mdion1/LightsAndSoundProj/Datasheets/MO063602-1 dimension capture.png

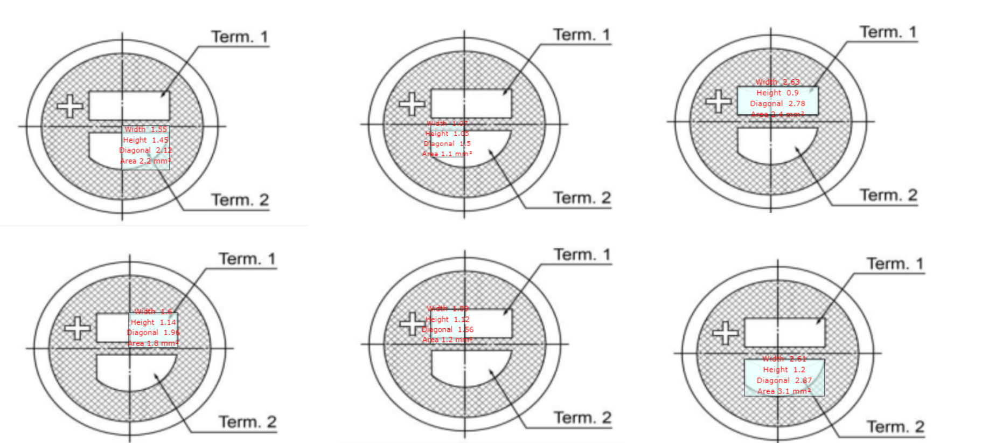
Datasheets/MO063602-1 dimension capture.png
