mdion1/LightsAndSoundProj/UsefulScripts/DFTFilterDesign/SampleScriptOutput.png

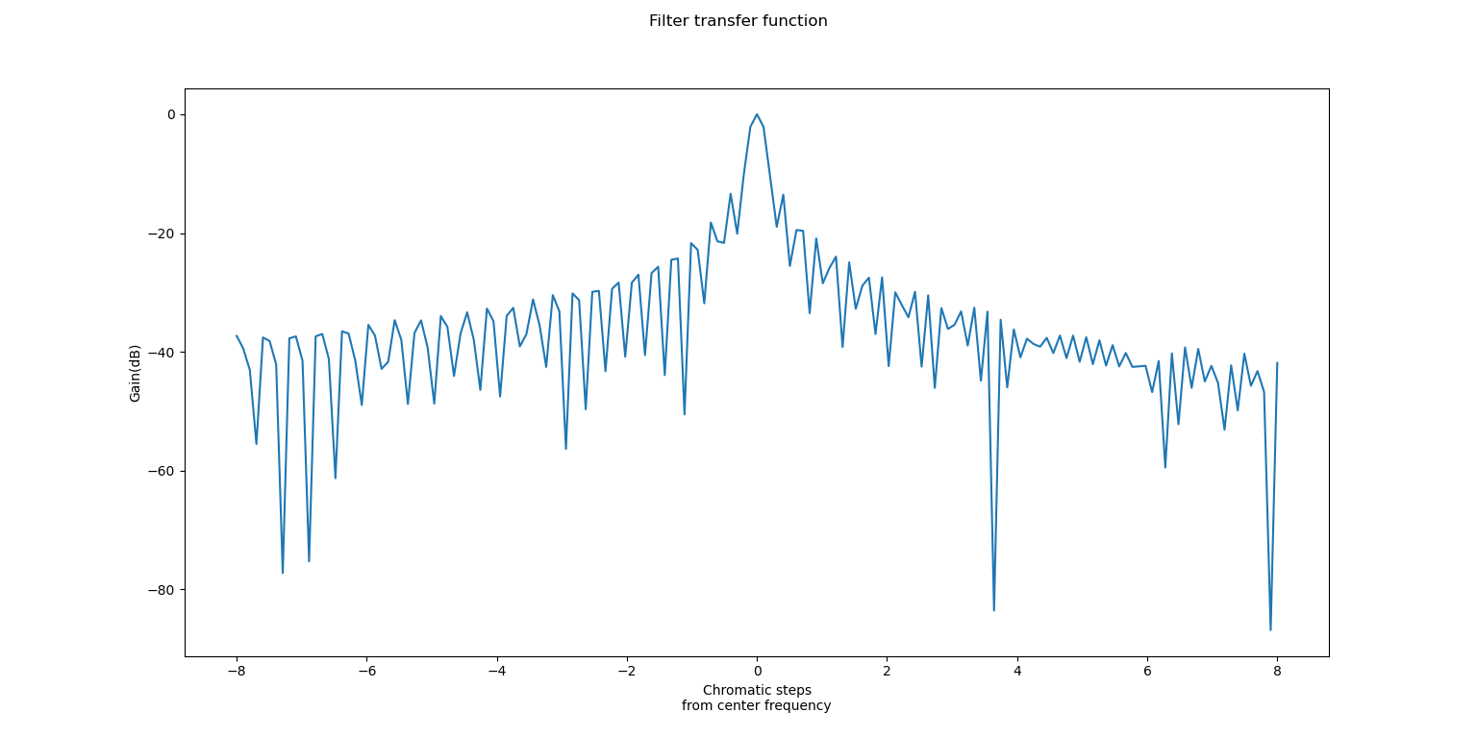
UsefulScripts/DFTFilterDesign/SampleScriptOutput.png
