mdion1/LightsAndSoundProj/Simulations/GainStage_DCanalysis.asc

C6: cap; 5p
C10: cap; 5p
C_pin: cap; 50p
R1: res; 10k
R9: res; 10k
R13: res; {R_fbTop}
R14: res; {R_fbTop}
R15: res; {R_fbBot}
R16: res; 1k
U1: UniversalOpAmp; Avol=0.5Meg GBW=0.73Meg Vos={V_inputOffset}; En=0 Enk=0 In=0 Ink=0 Rin=1e13
V1: voltage; 3.3
V2: voltage; 3.3
V4: voltage; 0
Named nets: 0, Vdd, AmpOut, Midscale2, Midscale1, ADC_in
Power rails
MIC
;PARAMETER GROUP 1 (LOW FREQUENCY)
 
;Amplifier stage
.param R_fbTop = 10Meg
.param R_fbBot  = 270k
.param V_inputOffset = 0.00
PIC analog input impedance model
Readme:
This simulation is for modeling the AC transfer function of the analog gain stage,
for debugging and component selection. Currently there are two "groups" of component
choices, one for notes below middle C (65 - 262Hz), and one for notes above middle C (262 - 1047Hz).
To simulate one group, uncomment the corresponding "Parameter Group" SPICE directive.
.dc v4 -0.1 0.1 0.05
