mdion1/LightsAndSoundProj/Simulations/GainStage.asc

C1: cap; 1µ
C2: cap; 1µ
C3: cap; 1n
C4: cap; 1n
C5: cap; {C_in}
C6: cap; 5p
C7: cap; {C_fb}
C8: cap; {C_fb}
C10: cap; 5p
C_pin: cap; 50p
R1: res; 10k
R2: res; 1k
R3: res; 10k
R4: res; 10Meg
R5: res; 10Meg
R6: res; 1k
R7: res; 10Meg
R8: res; 10Meg
R9: res; 10k
R11: res; {R_fbBot}
R13: res; {R_fbTop}
R14: res; {R_fbTop}
R15: res; {R_fbBot}
R16: res; 1k
U1: UniversalOpAmp; Avol=0.5Meg GBW=0.73Meg Vos=0; En=0 Enk=0 In=0 Ink=0 Rin=1e13
V1: voltage; 3.3
V4: voltage; 0; AC 1
Named nets: 0, Vdd, Audio_in, AmpOut, Midscale2, Midscale1, ADC_in
.ac dec 20 1 1e4
Power rails
MIC
;PARAMETER GROUP 1 (LOW FREQUENCY)
 
;Hi-pass input filter stage
.param C_in = 10n
 
;Amplifier stage
.param C_fb = 22p
.param R_fbTop = 10Meg
.param R_fbBot  = 270k
PIC analog input impedance model
;PARAMETER GROUP 2 (HIGH FREQUENCY)
 
;Hi-pass input filter stage
.param C_in = 1.5n
 
;Amplifier stage
.param C_fb = 10p
.param R_fbTop = 10Meg
.param R_fbBot  = 270k
Readme:
This simulation is for modeling the AC transfer function of the analog gain stage,
for debugging and component selection. Currently there are two "groups" of component
choices, one for notes below middle C (65 - 262Hz), and one for notes above middle C (262 - 1047Hz).
To simulate one group, uncomment the corresponding "Parameter Group" SPICE directive.
