mdion1/LightsAndSoundProj/firmware/HAL/PIC18F06Q41/hal_PWM.c

#ifdef __PIC18F06Q41__
#include "HAL/HAL_PWM.h"
#include "HAL/HAL_PMD.h"
#include <xc.h>

/** PWM allocation
 *
 * PWM1: Red (P1) and green (P2) LED drivers
 * PWM2: Blue (P1) LED driver
 * PWM3: unused
 */

/* With clock source = 1MHz HFINTOSC and period of 256, PWM frequency = 3.91kHz
 */
#define PWM_PERIOD 256

/* PWM1 output P1 = Red channel
 * PWM1 output P2 = Green channel
 * PWM2 output P1 = Blue channel
 */
#define PWM1S1P1_OUT 0x0a   // Peripheral pin select output register values
#define PWM1S1P2_OUT 0x0b
#define PWM2S1P1_OUT 0x0c

void HAL_initPWM()
{
    // do nothing
}

void HAL_PWMEnable(bool en)
{
    if (en)
    {
        HAL_PMD_enPWM(true);   // Clear Peripheral Module Disable bits
        PWMEN = 0b011;          // Enable PWM1 and PWM2
        
        /* Set clock source and period */
        PWM1CLK = 3; //HFINTOSC
        PWM2CLK = 3;
        PWM1PR = PWM_PERIOD;
        PWM2PR = PWM_PERIOD;
        
        // Assign GPIO's using the Peripheral Pin Select registers
        RC0PPS = PWM1S1P1_OUT;  // Red channel
        RC1PPS = PWM1S1P2_OUT;  // Green channel
        RC2PPS = PWM2S1P1_OUT;  // Blue channel
    }
    else
    {
        PWMEN = 0;              // Disable PWM1 and PWM2
        HAL_PMD_enPWM(false);   // Set Peripheral Module Disable bits
        
        // Set GPIO's back to digital outputs set to 0
        RC0PPS = 0;     // Red channel
        RC1PPS = 0;     // Green channel
        RC2PPS = 0;     // Blue channel
    }
}

void HAL_setPWM(uint8_t Rval, uint8_t Gval, uint8_t Bval)
{
    PWM1S1P1 = Rval;
    PWM1S1P2 = Gval;
    PWM2S1P1 = Bval;      
    PWMLOAD = 0b11; // set "load" bit for PWM1 and PWM2
}

#endif
