mdion1/LightsAndSoundProj/(commit log)

2022-12-16 Added prototype/development PCB design file subrepo
2022-12-26 started to better organize the SignalSamplingConfigurator python scripts; made "TransferFn" base class and derived classes to model system analog/digital signal chain behavior
2022-12-27 Started to populate HAL adc module; implemented ISR-based circular buffer logic with the SignalSampling.c module
2023-01-20 added comments about PIC18 timer specs and configurations
2023-02-03 Added circuit simulations
    Added python script for testing int-only math for HSV to RBG conversion
    More state machine code setup
2023-02-09 Updated board layout subrepo to rev 2; added manuals and datasheets; updated simulations to include 2 options, for both "high frequency" notes (>256Hz) and "low frequency" notes
2023-03-08 bugs: LinRamp_incr() was returning the wrong struct member; HAL_initADC() and HAL_initPWM() were not clearing the peripheral module disable bits when configuring registers; red and blue PWM channels 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
    added note-defining macro to configuration
    [hal_ADC.c, hal_PWM.c]
2023-03-09 Several small logic and HAL-level bugs
    [HAL_GPIO.c, HAL_sleepTimer.c, LEDManager.c, SamplingParams.h, SignalSampling.c, Sleep.c]
2023-03-09 More logic fixes; fixed Timer0 to operate during sleep
    [HAL_GPIO.c, HAL_sleepTimer.c, LEDManager.c]
2023-03-09 more bug fixes; todo: sampling is at the right frequency and is inconsistent
    [HAL_GPIO.c, LEDManager.c, SignalSampling.c]
2023-03-10 slight change of order in enabling/disabling ADC and Timer2; fixed sqrt float math
    [hal_ADC.c]
2023-03-10 EXPERIMENTAL/DEBUGGING COMMIT ONLY: sample buffer gets processed all at once instead of as you go.
2023-03-13 fixed some sampling index errors, tried a smaller buffer size just for testing
    [SignalSampling.c]
2023-03-15 Added an input guard to NPow2(), added comments to the exponential filter
2023-03-17 Fixed HAL-level bugs, PMD registers will not only disable a module, they will reset its registers
    [HAL_sleepTimer.c, LEDManager.c, Sleep.c, hal_ADC.c]
2023-03-19 Bug: Sleep.c and LEDManager.c state machines weren't resetting their timebase after wakeup
    [Sleep.c]
2023-03-19 Bug: sampling configurator was calculating number of cycles per LED refresh and Sleep check, but timebase is in number of samples
    [SamplingParams.h]
2023-03-19 Sleep timer values were adding 1 to get timer period, not subtracting one
2023-03-19 Peripheral module disable bits were clearing PWM settings
2023-03-19 bug fix: reset LED manager's time count
    [LEDManager.c]
2023-03-19 HAL_sleep() wasn't being called during ADC sampling
2023-03-20 Added tests/SleepTest.c that replaces main.c (testing configuration only); got rid of some todo comments
    [HAL_GPIO.c, HAL_globalIntMask.c, HAL_sleepTimer.c, LEDManager.c, SignalSampling.c, Sleep.c, Sleep.h]
2023-03-20 Updated GainStage simulation to reflect most current BOM; updated NoteDector_PCBA subrepo to include BOM changes to Rev 3 (layout still not completed)
2023-03-21 Updated PCB design files
2024-12-07 WIP squash later; gain stage simulation update (getting rid of a midscale reference); tuning routine C-code
